Gangleri42/sh-hardware/seed/seed.step

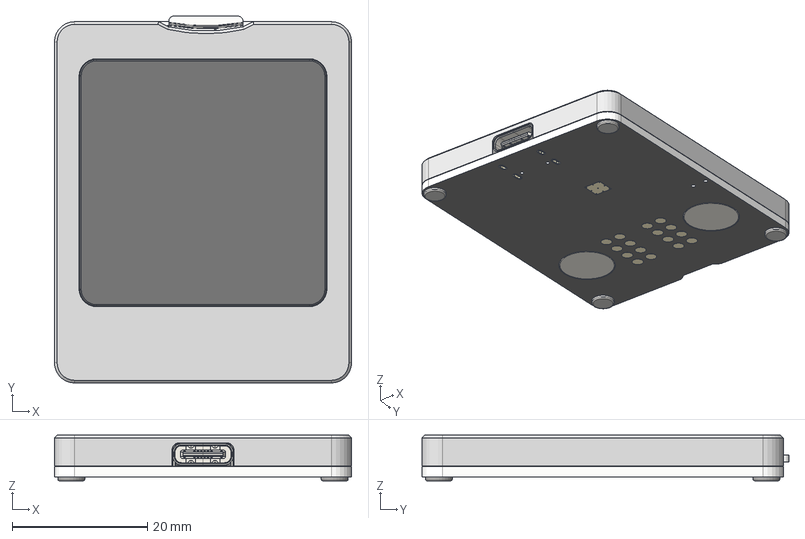
[picture p3: CAD file, 2026-11-11]
seed/seed.step
44.0 x 54.3 x 6.76 mm
Frame
Display_2in_square
microSD_card_15x11x1
seed_PCB
Screw_M2x5_wafer_black x 4
Magnet_N52_10x1.6_head_12x0.8_seed x 2
