Gangleri42/sh-hardware/seed/Seed-v38.step

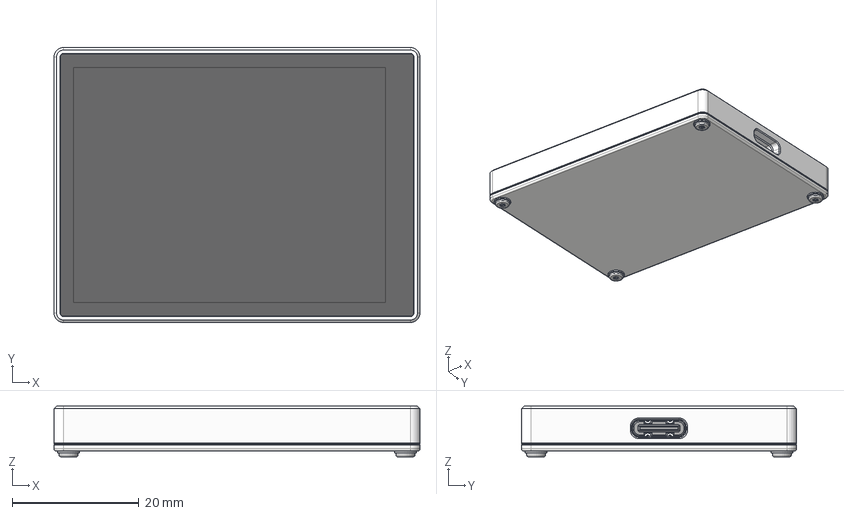
[picture p5: CAD file, 2026-10-07, an earlier design]
seed/Seed-v38.step
57.9 x 43.5 x 8.03 mm
BW0041CG-L2.5W1.0H1.8 x 2
DRT_3
