Gangleri42/sh-hardware/seed/Seed-v32.step

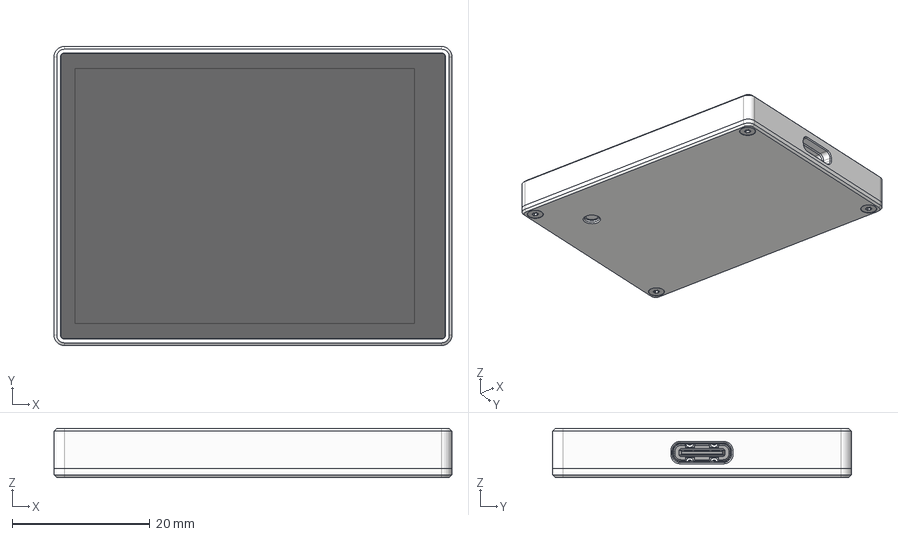
[picture p6: CAD file, 2026-10-06, an earlier design]
seed/Seed-v32.step
57.9 x 43.5 x 7.13 mm
ISO 14581 - M1.6x4 Edelstahl A2 Einfach x 4
