Gangleri42/sh-hardware/(list of files, cad)

Other CAD files:
hammer/Hammer-v61.step
hammer/Hammer-v58.step
seed/Seed-v26.step
hammer/Hammer-v55.step
seed/Seed-v22.step
hammer/Hammer-v41.step
seed/Seed-v20.step
seed/Seed-v17.step
seed/Seed-v15.step
seed/Seed-v13.step
seed/Seed-v7.step
